Long-Conor/BJT-Amplifier-Design/Single_stage_amplifier/FINAL ASSIGNMENT_PAIR 7.pdf

1 | P a g e

2021C

## RMIT University Vietnam

## School of Science and Technology (SST)

## EEET2600 – Electronics

# BJT AMPLIFIER DESIGN

## Lecturer: Mr. Thanh Pham

## Team Members:

## Student 1 (Nguyen Huynh Hai Long) (S3877624)

## Student 2 (Hoang Thai Kiet) (S3855250)

## Date: 15/01/2022

## Table of Contents

## CIRCUIT 1 – ANALYZING SINGLE-STAGE AMPLIFIER

In this following task, we will be analyzing as well as designing a suitable circuit from the provided

BJT Amplifier schematic through the usage of Multisim Simulation and Elvis Build. From the

given circuit of the single-stage amplifier, we would first analyze the DC bias of the circuit and

determine the Q-point values.

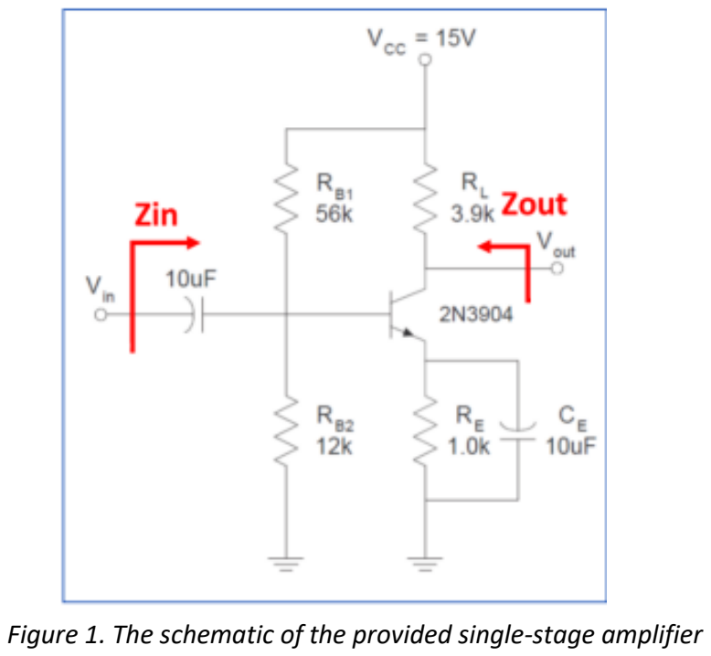
[picture p1: figure]

### 1.1.DC Analysis (1.5 pages max)

We determine the values of the Q-point (ICEQ and VCEQ) by applying the equations:

Figure 1. The schematic of the provided single-stage amplifier

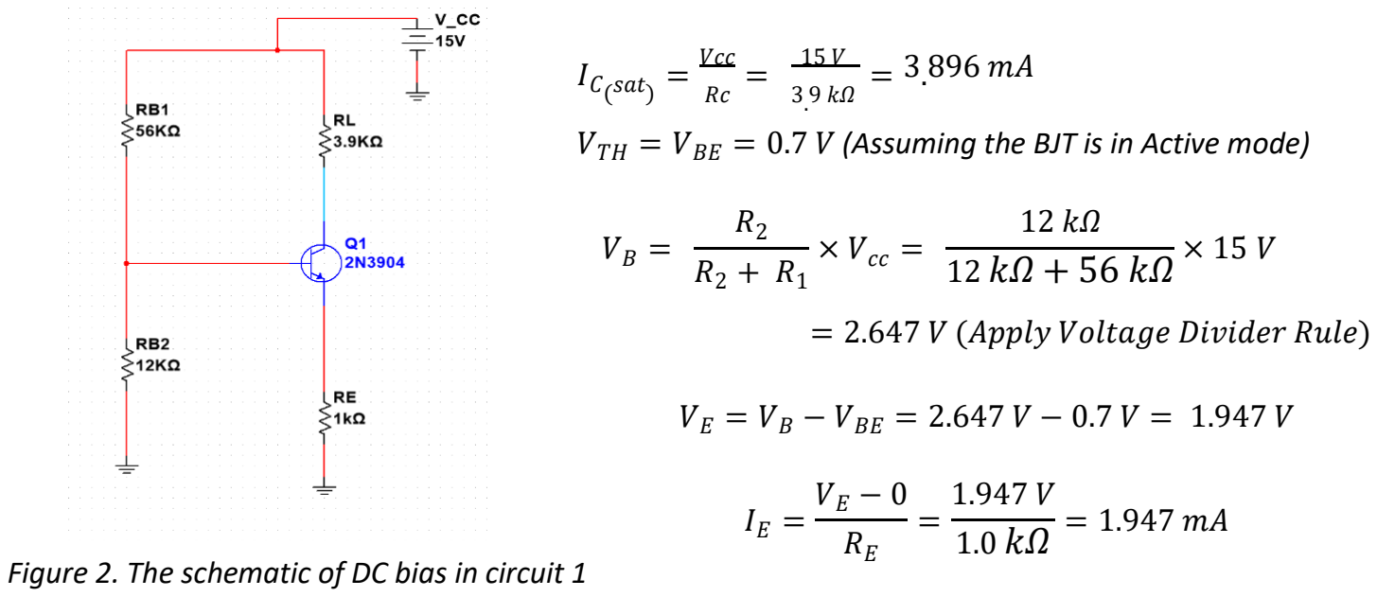
[picture p2: figure]

| Vcc 15 V = 3.896 mA IC( = = sat) Rc 3. 9 kΩ VTH = VBE = 0.7 V (Assuming the BJT is in Active mode) R2 12 kΩ VB = × Vcc = 12 kΩ + 56 kΩ × 15 V R2 + R1 = 2.647 V (Apply Voltage Divider Rule) VE = VB − VBE = 2.647 V − 0.7 V = 1.947 V VE − 0 1.947 V IE = = 1.0 kΩ = 1.947 mA

Figure 2. The schematic of DC bias in circuit 1

IE = IB + IC =

1
β

IC + IC ⇒ IC = (

β
β + 1

) × IE =

100
100 + 1

× 1.947 mA = 1.928 mA

### VCE = VCC − ICRC − IERE = 15 V − (1.928 mA × 3.9 kΩ) − (1.947 mA × 1.0 kΩ) = 5.534 V

⇒ Q(ICQ,VCEQ) = (1.928 mA, 5.534 V).

Draw the Q point together with the DC load line. From there determine the maximum output swing

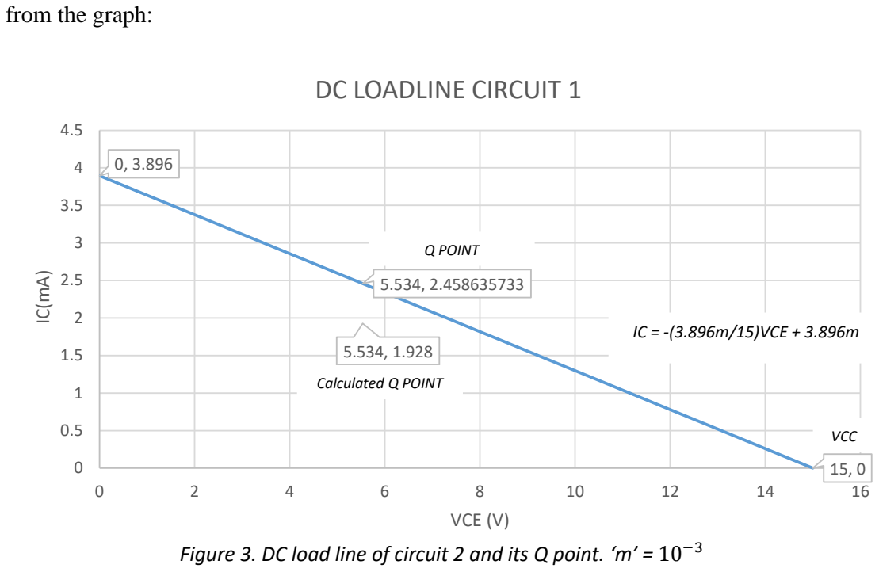
[picture p3: figure]
from the graph:; IC = -(3.896m/15)VCE + 3.896m; VCE (V); DC LOADLINE CIRCUIT 1; Calculated Q POINT; Q POINT; VCC

By looking at the DC load line graph, we observe that the actual Q point in circuit 1 is Q

(2.458635733mA, 5.534V by substituting VCE = 5.534V to the equation IC, which is evaluated

from the coordinates of IC saturation and VCC. To guarantee its maximum output swing, VCE is

foreseen to oscillate in a range: 0 < VCE ≤ 2 ∗ VCEQ = 5.534 ∗ 2 = 11.068, if the VCE

maximum output swing is larger than 11.068, the left wing will be clipped as it exceeds the cutoff

point. Similarly, if the maximum output swing is larger than VCC=9V, VCE will experience both

its sides clipped. As a result, the maximum output swing is 11.068.

### 1.2.AC Analysis (2 pages max)

With values of the Q-point from the DC Analysis, we continued by calculating the h-parameters

for small-signal models:

Figure 3. DC load line of circuit 2 and its Q point. ‘m’ = 10⁻³

gm =

IC
VT

=

1.928 mA
25 mV = 0.07712

Input resistance rπ =

β0
IC

× VT =

100
1.928 mA

× 25 mV = 1296.680 Ω = 1.297 kΩ

Output resistance r0 =

VA + VCE
IC

=

75 V + 5.534 V
1.928 mA = 41.770 kΩ

Then draw the small-signal circuit below:

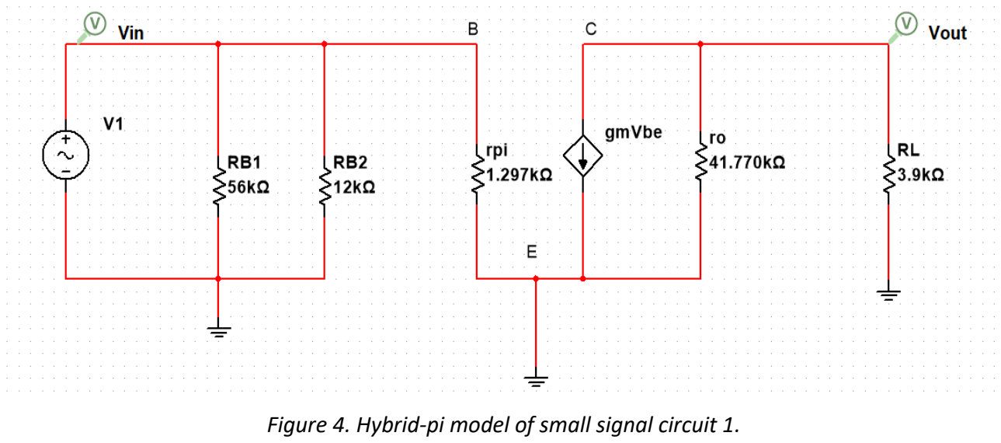
[picture p4: figure]

Utilizing the circuit above from figure., we applied the values from previous DC Analysis and h-

parameters into the formulas of:

- Gain

Av =

V0

VBE

=

V0

Vin

= −gm (

RL × R0
RL + R0

) = −0.07712 × (

3.9 kΩ × 41.770 kΩ
3.9 kΩ + 41.770 kΩ) = −275.084
- Zin

RB =

RB1 × RB2

RB1 + RB2

=

(56 kΩ × 12 kΩ)
(56 kΩ + 12 kΩ)

= 9882.353 Ω = 9.882 kΩ

Zin =

RB × Rπ
RB + Rπ

=

(9.882 kΩ × 1.297 kΩ)
(9.882 kΩ + 1.297 kΩ)

= 1146.520 Ω

- Zout

Figure 4. Hybrid-pi model of small signal circuit 1.

) = (

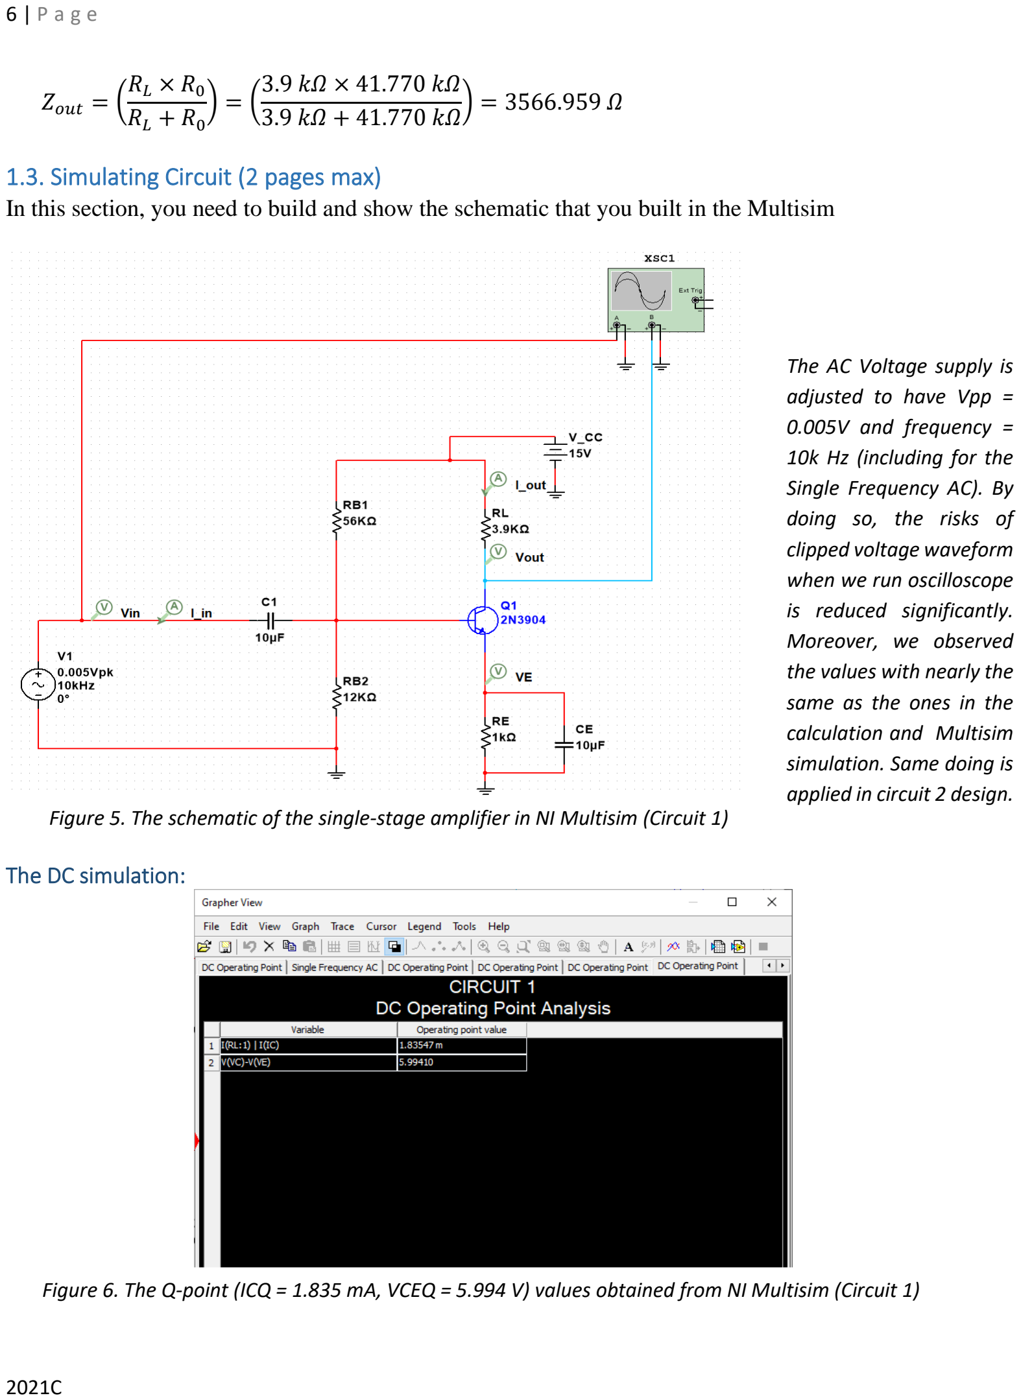
[picture p5: page 6]

Zout = (

RL × R0
RL + R0

3.9 kΩ × 41.770 kΩ
3.9 kΩ + 41.770 kΩ) = 3566.959 Ω

### 1.3. Simulating Circuit (2 pages max)

In this section, you need to build and show the schematic that you built in the Multisim

The DC simulation:

Figure 5. The schematic of the single-stage amplifier in NI Multisim (Circuit 1)

The AC Voltage supply is
adjusted to have Vpp =
0.005V and frequency =
10k Hz (including for the
Single Frequency AC). By
doing so, the risks of
clipped voltage waveform
when we run oscilloscope
is reduced significantly.
Moreover, we observed
the values with nearly the same as the ones in the
calculation and Multisim
simulation. Same doing is
applied in circuit 2 design.

Figure 6. The Q-point (ICQ = 1.835 mA, VCEQ = 5.994 V) values obtained from NI Multisim (Circuit 1)

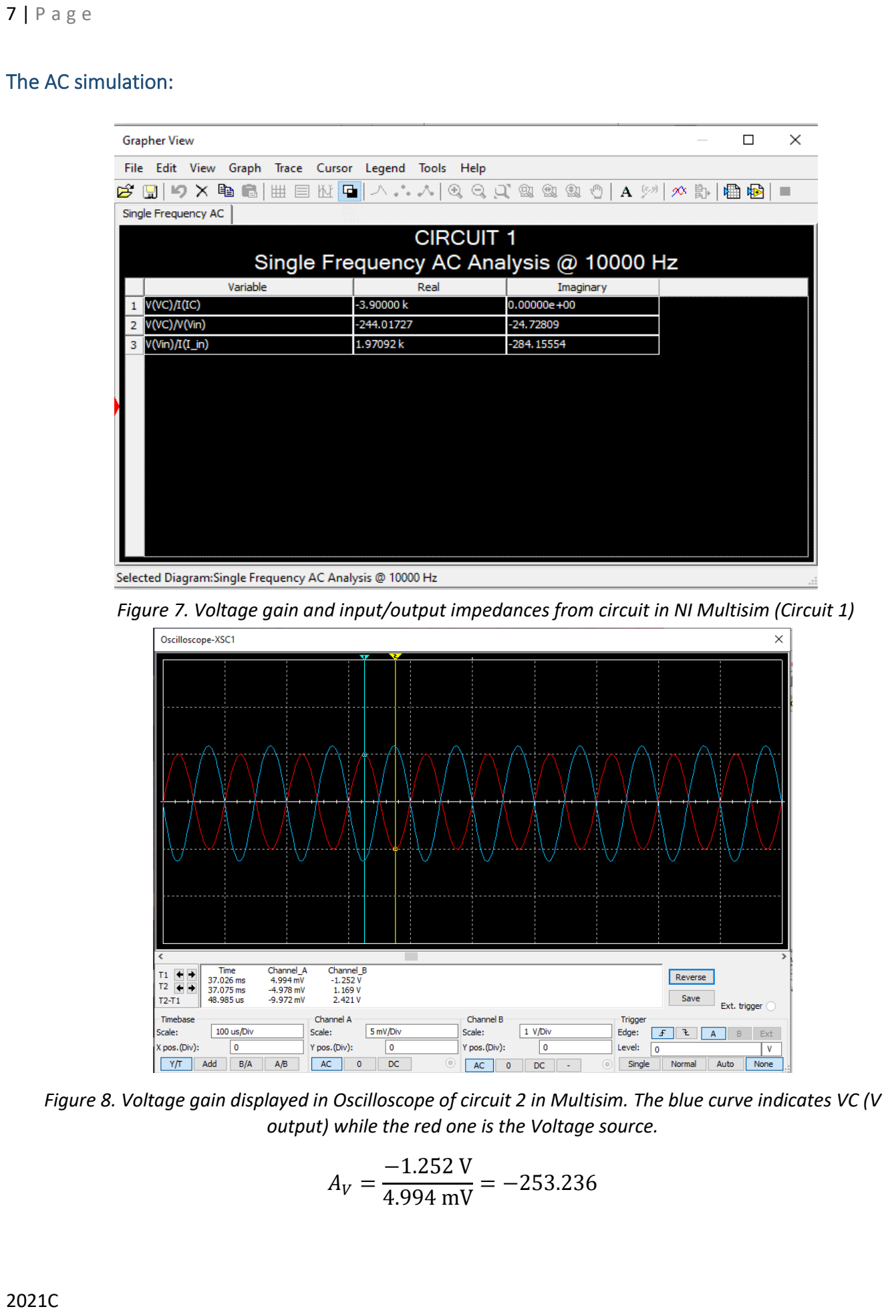
[picture p6: page 7]

The AC simulation:

Figure 7. Voltage gain and input/output impedances from circuit in NI Multisim (Circuit 1)

Figure 8. Voltage gain displayed in Oscilloscope of circuit 2 in Multisim. The blue curve indicates VC (V output) while the red one is the Voltage source.

AV =

−1.252 V
4.994 mV = −253.236

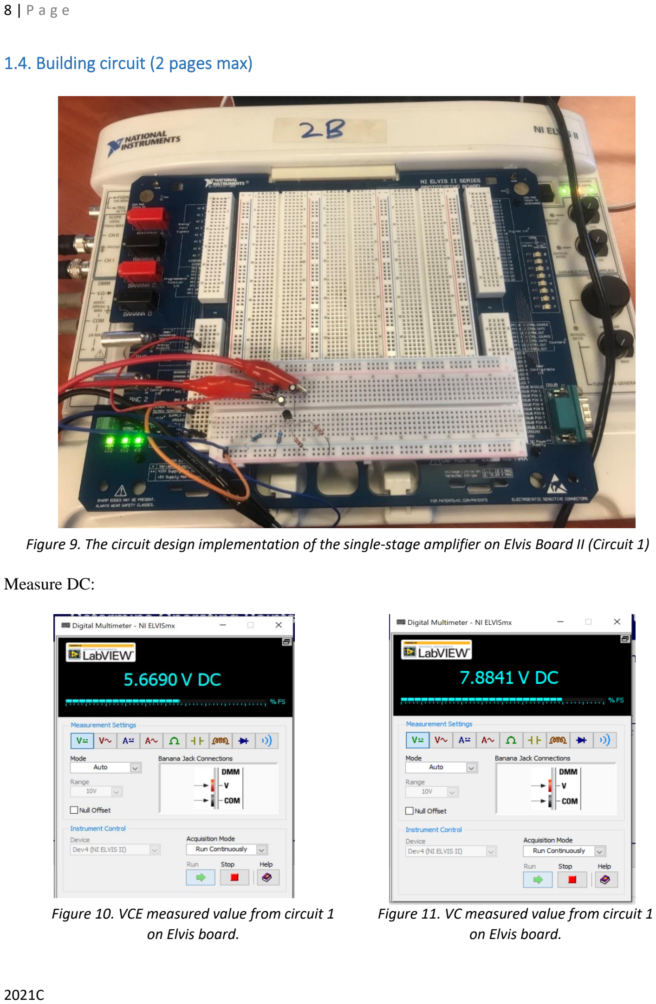
[picture p7: page 8]

### 1.4. Building circuit (2 pages max)

Measure DC:

Figure 9. The circuit design implementation of the single-stage amplifier on Elvis Board II (Circuit 1)

Figure 10. VCE measured value from circuit 1 on Elvis board.

Figure 11. VC measured value from circuit 1 on Elvis board.

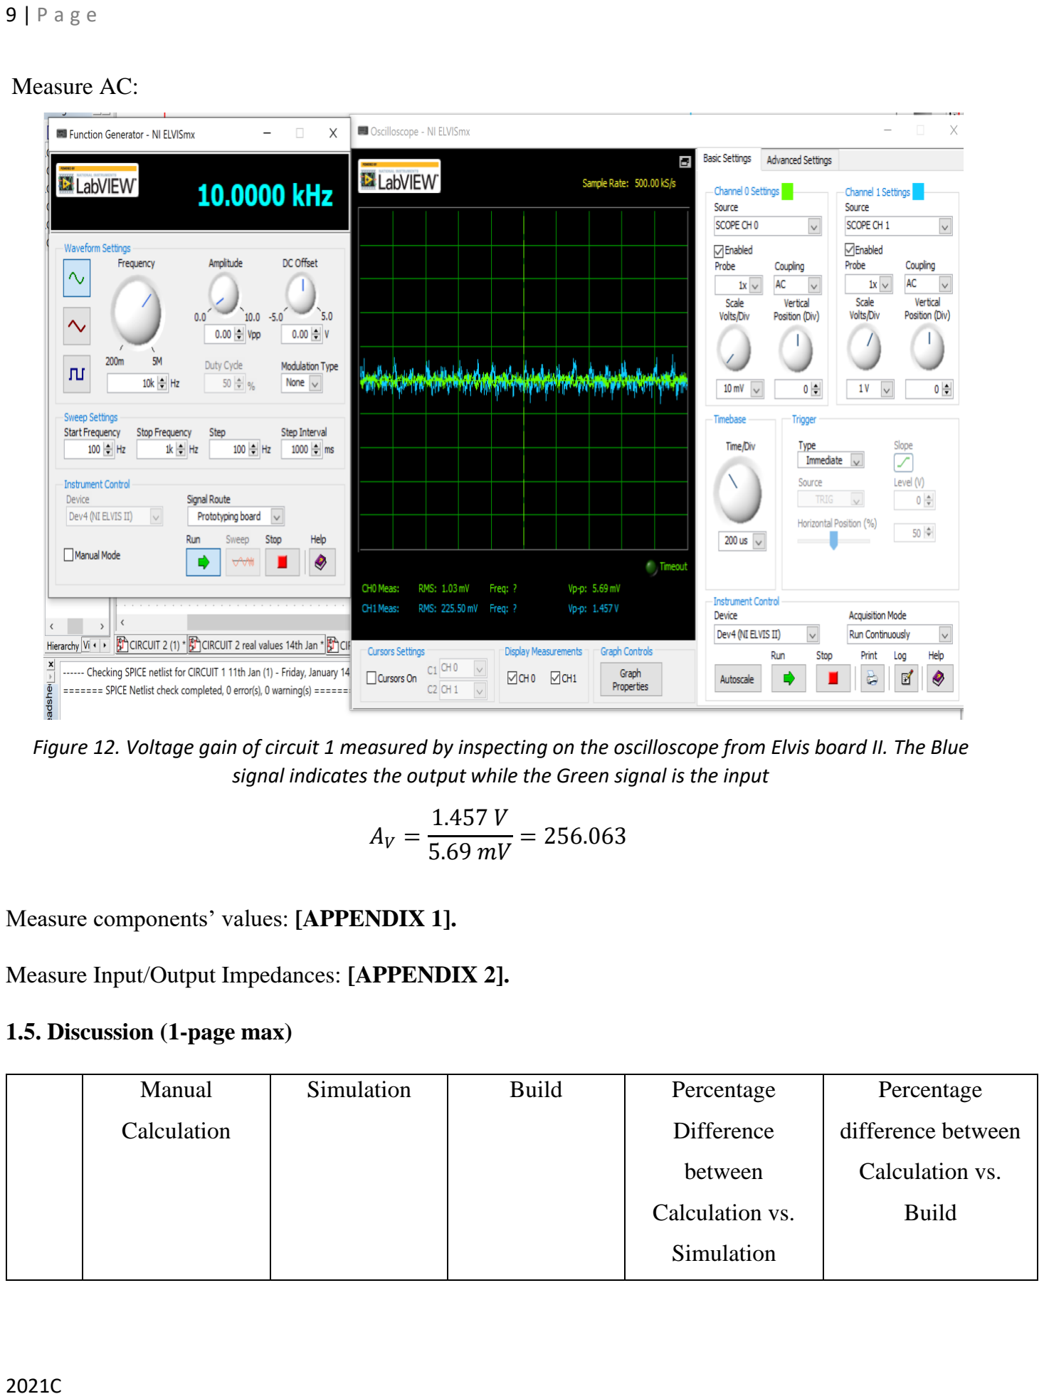
[picture p8: page 9]

Measure AC:

Measure components’ values: [APPENDIX 1].

Measure Input/Output Impedances: [APPENDIX 2].

### 1.5. Discussion (1-page max)

Manual

Calculation

Simulation | Build | Percentage
| | Difference
| | between
| | Calculation vs.
| | Simulation

Percentage

difference between

Calculation vs.

Build

Figure 12. Voltage gain of circuit 1 measured by inspecting on the oscilloscope from Elvis board II. The Blue signal indicates the output while the Green signal is the input

AV =

1.457 V
5.69 mV = 256.063

DC – Q-point | (ICQ): 1.928mA (VCEQ): 5.334V Max output swing(MOS): 11.068V | (ICQ): 1.835mA (VCEQ): 5.994V (MOS): 5.994*2=11.988 | (ICQ): 2.032mA (VCEQ): 5.669V (MOS): 5.669*2=11.338 | (ICQ): 4.824 % (VCEQ): 12.373% (MOS): 8.312% | (ICQ): 5.394 % (VCEQ): 6.280% (MOS): 2.891%
AC – Av | -275.084 | -244.017 | 256.063 | 11.294 % | 6.915 %
AC – Zin | 1146.520 Ω | 1970.920 Ω | 1093.629 Ω | 71.905 % | 4.613 %
AC – Zout | 3566.959 Ω | -3900 Ω | 3534.881 Ω | 9.337 % | 0.899 %

Table 1. Result table of Calculation Vs Simulation Vs Build, along with the percentage difference

between each value (Circuit 1)

% Difference = |1 −

Simulated Multisim Value or Elvis Board Value
Manual Calculated Value | | × 100%

Overall, the analysis and the implementation of building the given first-stage amplifier went

indisputably as the circuit design includes all of the required components needed in the schematic

and were able to obtain results from both Multisim Simulation and Elvis Build.

However, it is worth pointing out that despite the differences among the majority of values between

calculation, simulation and built model; can be seen as having only slightly more when compared

with each other (as shown in [Table 1]), there is one particular difference between the calculation’s

vs simulation at AC – Zin that has a very high percentage difference when compared with the rest.

While the percentage difference between the calculation vs builds for AC – Zin is only at 4.613%,

the percentage difference between the calculation vs simulation for AC – Zin is at its highest of

71.905% (as shown in [Table 1]).

There is no clear explanation for such a significant percentage indifference for the values of AC-

Zin, but one theory might have suggested that it is due to the method of obtaining the Q-point

values between the manual calculation and simulation are not similar. This is further supported by

the difference in Q-point values and max output swing (MOS) between the two methods where

the Q-point and MOS values of manual calculation are Q (1.928 mA, 5.334 V), MOS=11.068V whereas the Q-point values of simulation are Q (1.835 mA, 5.994 V), MOS=11.988V (this greatly

affect the results of the input resistance in the h-parameter and later altered the values of Zin). Aside

from that, the rest of the values from the calculation, simulation and build witness a considerable

difference which is likely due to the connection hole on the breadboard along with the Elvis board

might be too loose (causing the measurement equipment to be less accurate) and the resistor values

are not identical when measured on the board. Further adjustment of wiring connection, choosing

new resistor, and swapping out new breadboard would increase the accuracy and reliability for

testing and designing.

## CIRCUIT 2 – DESIGN SINGLE-STAGE AMPLIFIER (12 PAGES MAXIMUM)

For this particular task, we will be developing a circuit for the single-stage Common Emitter

amplifier and analyzing the circuit according to the required specifications. To build a suitable

circuit that would meet the requirement, we must choose the values for all the resistors along with

all the capacitors present in the schematic. Additionally, the design must utilize the power supply

VCC = 9V; has both AC coupled input and output; a minimum gain at 1KHz of AV = -10 and the

amplifier works for maximum symmetrical output swing. Moreover, the BJT model we used for

circuit 2 design is 2N2222A because it is already available for in our system.

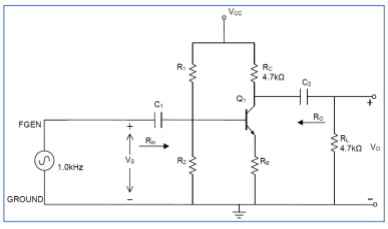
[picture p9: figure]

Figure 13. The schematic of the single-stage Common Emitter amplifier (Circuit 2)

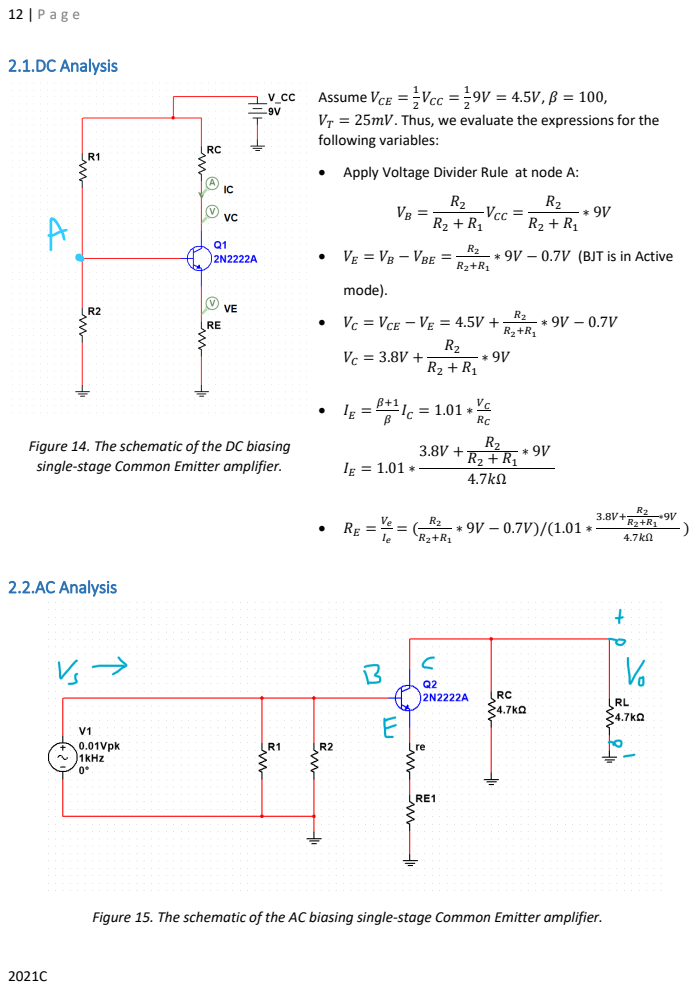
[picture p10: page 12]
2.1.DC Analysis; 2.2.AC Analysis; VCC =; mode).

Assume VCE =
VT = 25mV. Thus, we evaluate the expressions for the
following variables:

• Apply Voltage Divider Rule at node A:

∗ 9V − 0.7V (BJT is in Active

• VE = VB − VBE =

• VC = VCE − VE = 4.5V +

Figure 14. The schematic of the DC biasing
single-stage Common Emitter amplifier.

Figure 15. The schematic of the AC biasing single-stage Common Emitter amplifier.

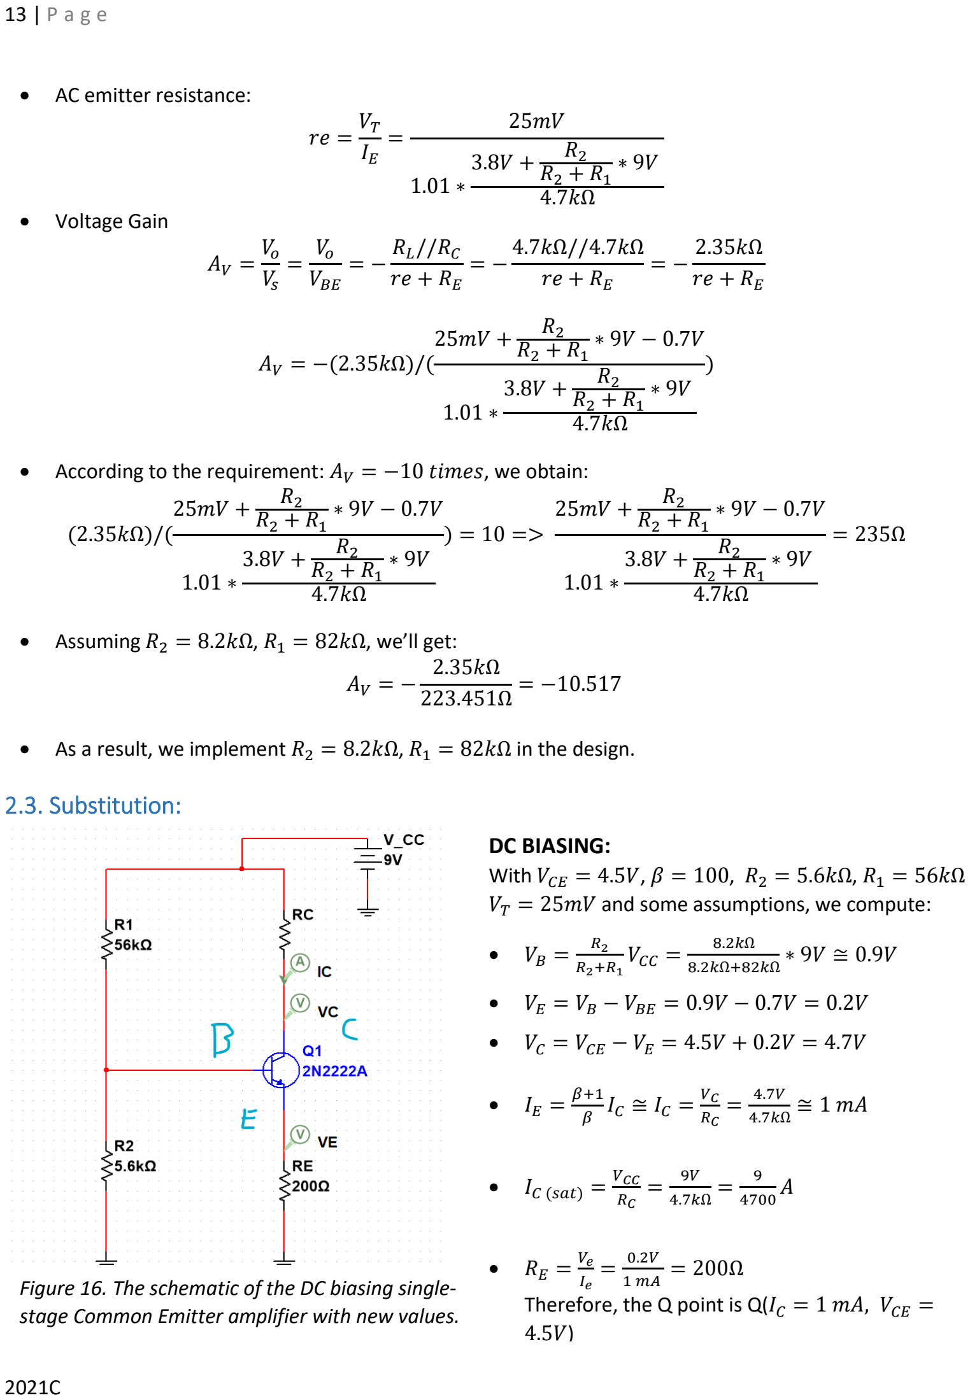
[picture p11: page 13]

### 2.3. Substitution:

- AC emitter resistance:

re =

VT
IE

=

25mV

1.01 ∗

3.8V +

R2
R2 + R1

∗ 9V
4.7kΩ
- Voltage Gain

AV =

Vo
Vs

=

Vo

VBE

= −

RL//RC
re + RE

= −

4.7kΩ//4.7kΩ
re + RE

= −

2.35kΩ
re + RE

AV = −(2.35kΩ)/(

25mV +

R2
R2 + R1

∗ 9V − 0.7V

1.01 ∗

3.8V +

R2
R2 + R1

∗ 9V
4.7kΩ

)

- According to the requirement: AV = −10 times, we obtain:

(2.35kΩ)/(

25mV +

R2
R2 + R1

∗ 9V − 0.7V

1.01 ∗

3.8V +

R2
R2 + R1

∗ 9V
4.7kΩ

) = 10 =>

25mV +

R2
R2 + R1

∗ 9V − 0.7V

1.01 ∗

3.8V +

R2
R2 + R1

∗ 9V
4.7kΩ

= 235Ω

- Assuming R2 = 8.2kΩ, R1 = 82kΩ, we’ll get:

AV = −

2.35kΩ
223.451Ω = −10.517
- As a result, we implement R2 = 8.2kΩ, R1 = 82kΩ in the design.

DC BIASING:
With VCE = 4.5V, β = 100, R2 = 5.6kΩ, R1 = 56kΩ VT = 25mV and some assumptions, we compute:
- VB =

R2
R2+R1

VCC =

8.2kΩ
8.2kΩ+82kΩ

∗ 9V ≅ 0.9V

- VE = VB − VBE = 0.9V − 0.7V = 0.2V
- VC = VCE − VE = 4.5V + 0.2V = 4.7V
- IE =

β+1
β

IC ≅ IC =

VC
RC

=

4.7V
4.7kΩ

≅ 1 mA

- IC (sat) =

VCC
RC

=

9V
4.7kΩ

=

9
4700

A

- RE =

Ve
Ie

=

0.2V
1 mA

= 200Ω
Therefore, the Q point is Q(IC = 1 mA, VCE = 4.5V)

Figure 16. The schematic of the DC biasing single-stage Common Emitter amplifier with new values.

AC BIASING

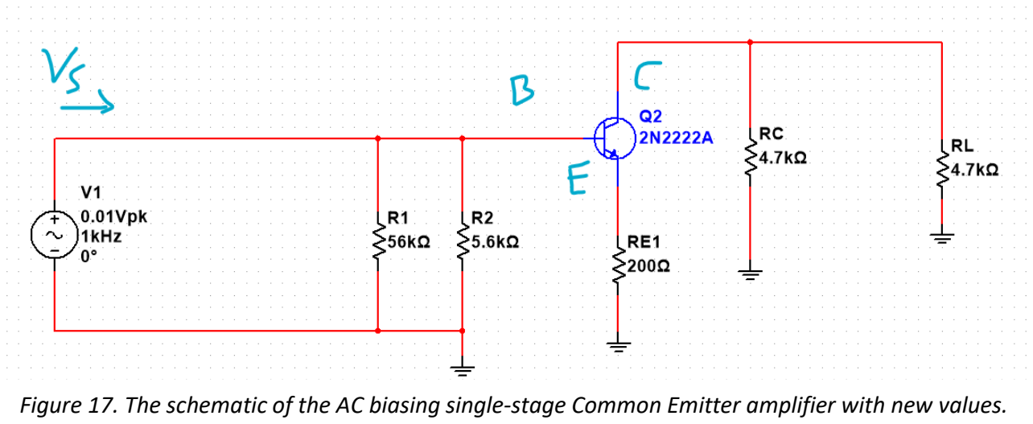
[picture p12: figure]
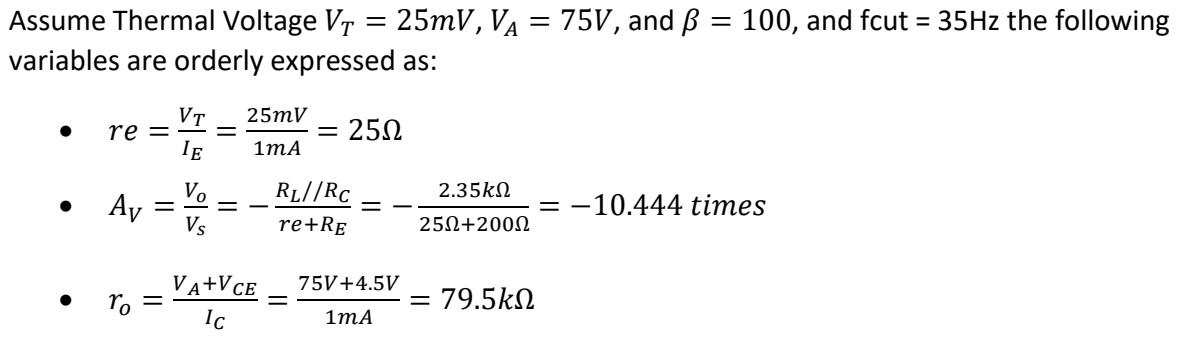
[picture p13: figure]
variables are orderly expressed as:; = −10.444 times; VA+VCE

Assume Thermal Voltage VT = 25mV, VA = 75V, and β = 100, and fcut = 35Hz the following

Figure 17. The schematic of the AC biasing single-stage Common Emitter amplifier with new values.

- Zin = (R1//R2)//β(re + RE) = (8.2kΩ//82kΩ)//150(25Ω + 200Ω)

Zin = 7.454kΩ//22.5kΩ = 5. 599kΩ

- Zout = (RC)//ro = (RL) (rois too big so we can neglect it)
Zout = 4. 7kΩ

With f=35Hz, we can adjust the values for the Capacitors by doing as followed:

- The XC1 of the coupling capacitor, C1, should be at least 10 times less than Zin

C1 =

1
2π ∗ (f = 35Hz) ∗ XC1

=

1
2π ∗ 35Hz ∗ 0.1 ∗ Zin

= 9. 465µF

- The XC2 of the coupling capacitor, C2, should be at least 10 times less than Zin

C1 =

1
2π ∗ (f = 35Hz) ∗ XC2

=

1
2π ∗ 35Hz ∗ 0.1 ∗ Zout

= 9. 675µF

So, we will pick C1 = C2 = 10µF for the design implementation on Elvis board.

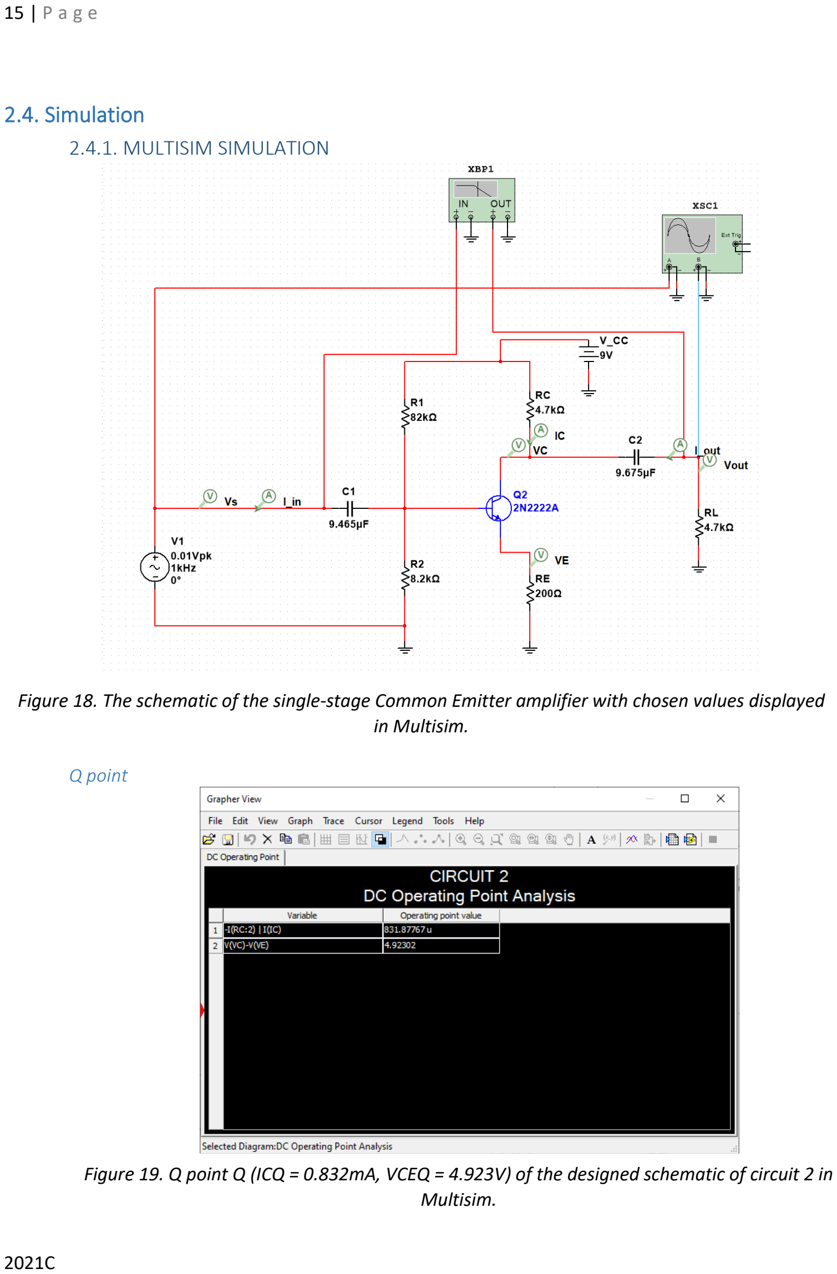
[picture p14: page 15]

### 2.4. Simulation

2.4.1. MULTISIM SIMULATION

Q point

Figure 18. The schematic of the single-stage Common Emitter amplifier with chosen values displayed in Multisim.

Figure 19. Q point Q (ICQ = 0.832mA, VCEQ = 4.923V) of the designed schematic of circuit 2 in Multisim.

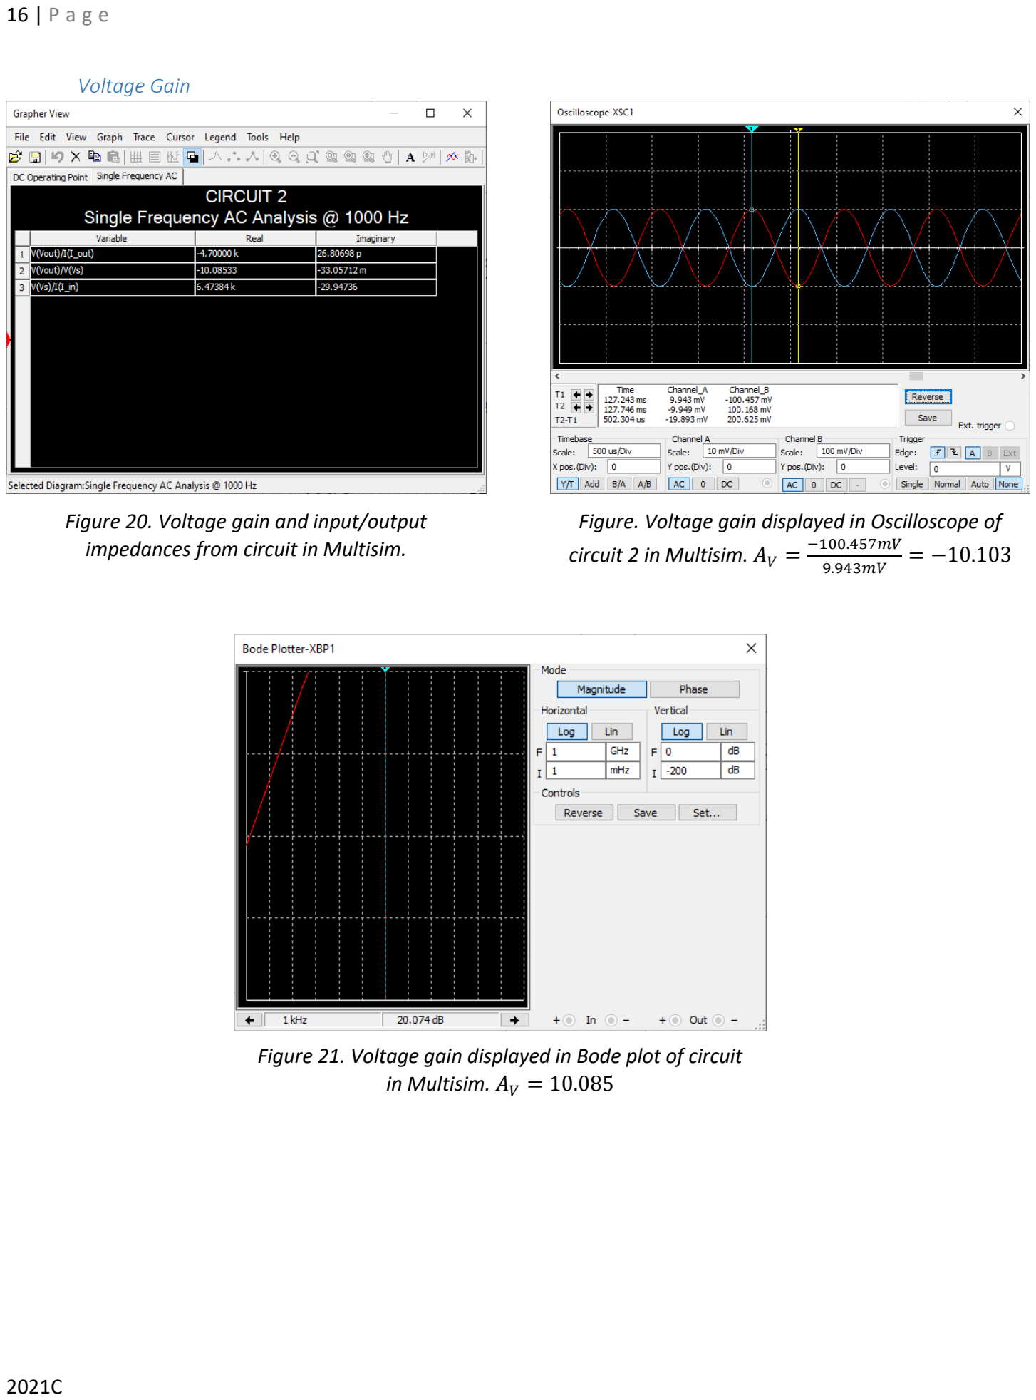
[picture p15: page 16]

Voltage Gain

Figure 20. Voltage gain and input/output impedances from circuit in Multisim.

Figure. Voltage gain displayed in Oscilloscope of circuit 2 in Multisim. AV =

−100.457mV
9.943mV

= −10.103

Figure 21. Voltage gain displayed in Bode plot of circuit in Multisim. AV = 10.085

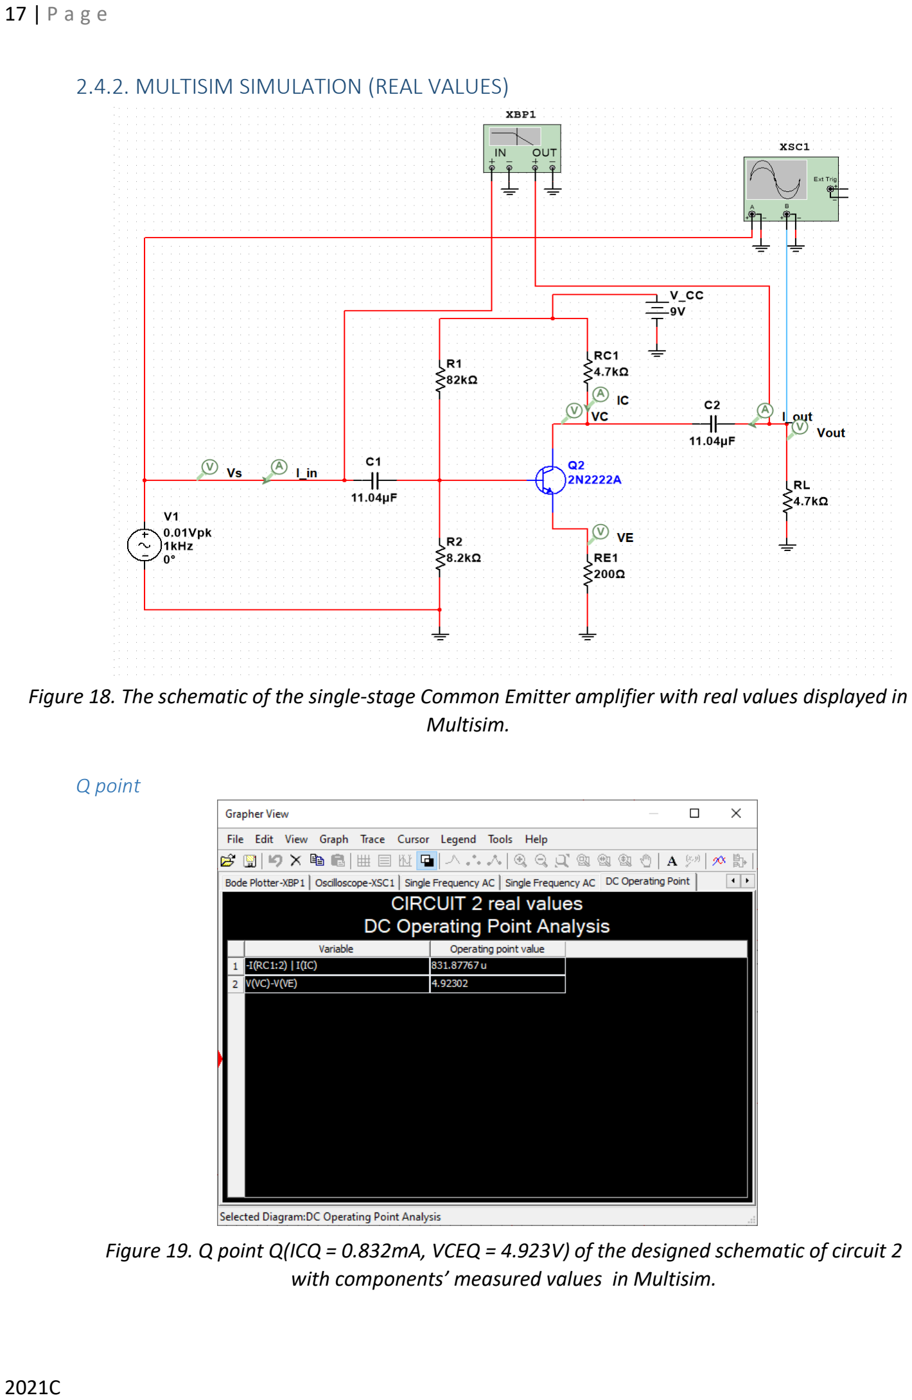
[picture p16: page 17]

2.4.2. MULTISIM SIMULATION (REAL VALUES)

Q point

Figure 18. The schematic of the single-stage Common Emitter amplifier with real values displayed in Multisim.

Figure 19. Q point Q(ICQ = 0.832mA, VCEQ = 4.923V) of the designed schematic of circuit 2 with components’ measured values in Multisim.

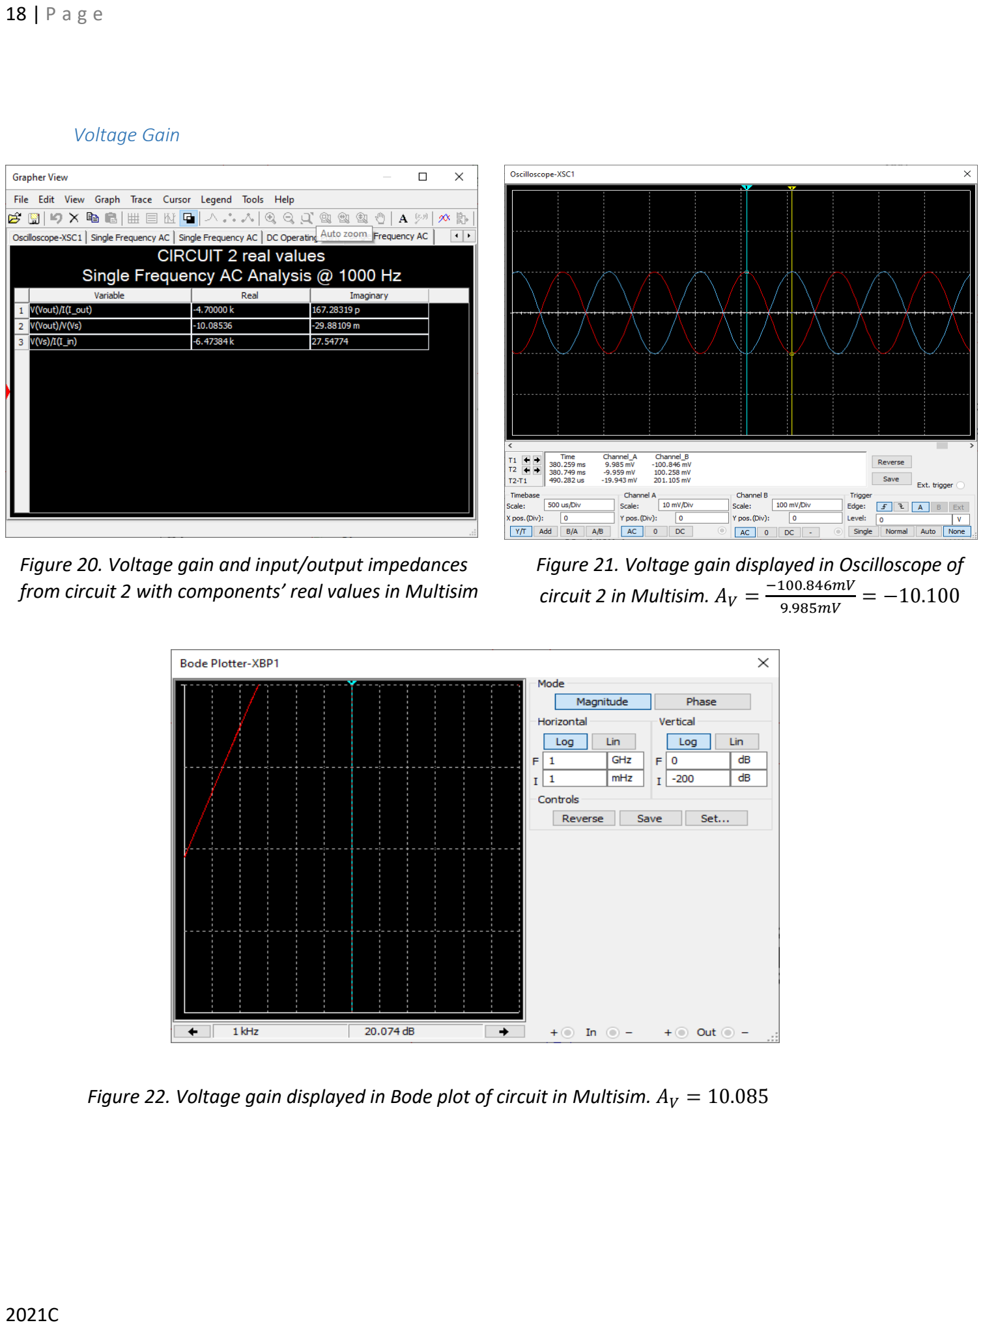
[picture p17: page 18]

Voltage Gain

Figure 22. Voltage gain displayed in Bode plot of circuit in Multisim. AV = 10.085

Figure 20. Voltage gain and input/output impedances from circuit 2 with components’ real values in Multisim

Figure 21. Voltage gain displayed in Oscilloscope of circuit 2 in Multisim. AV =

−100.846mV
9.985mV

= −10.100

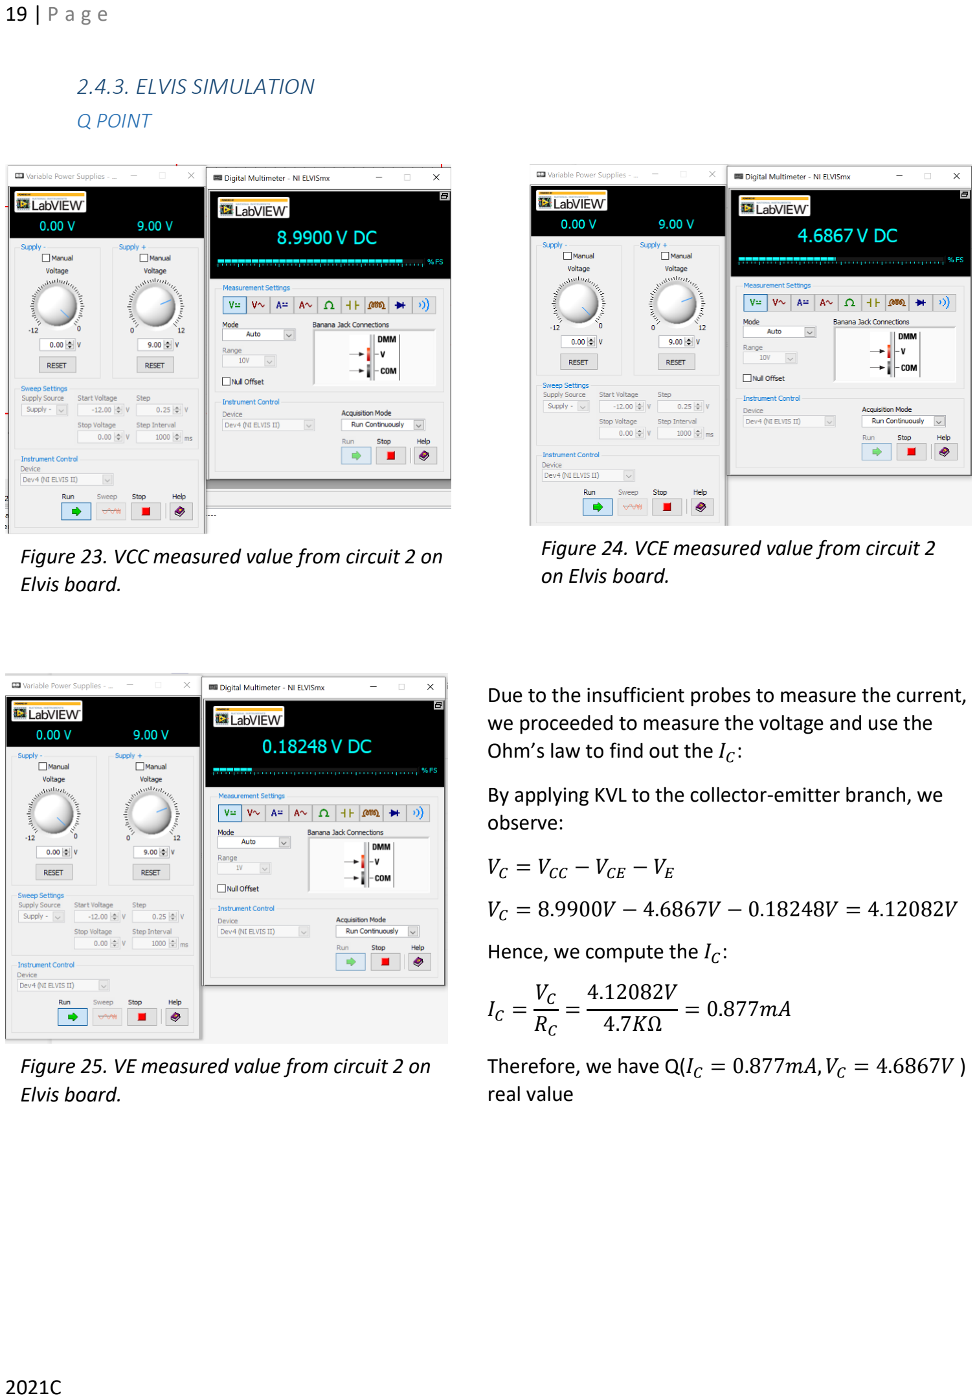
[picture p18: page 19]

2.4.3. ELVIS SIMULATION
Q POINT

Figure 23. VCC measured value from circuit 2 on Elvis board.

Figure 24. VCE measured value from circuit 2 on Elvis board.

Figure 25. VE measured value from circuit 2 on Elvis board.

Due to the insufficient probes to measure the current, we proceeded to measure the voltage and use the Ohm’s law to find out the IC:

By applying KVL to the collector-emitter branch, we observe:

VC = VCC − VCE − VE

VC = 8.9900V − 4.6867V − 0.18248V = 4.12082V

Hence, we compute the IC:

IC =

VC
RC

=

4.12082V
4.7KΩ

= 0.877mA

Therefore, we have Q(IC = 0.877mA, VC = 4.6867V ) real value

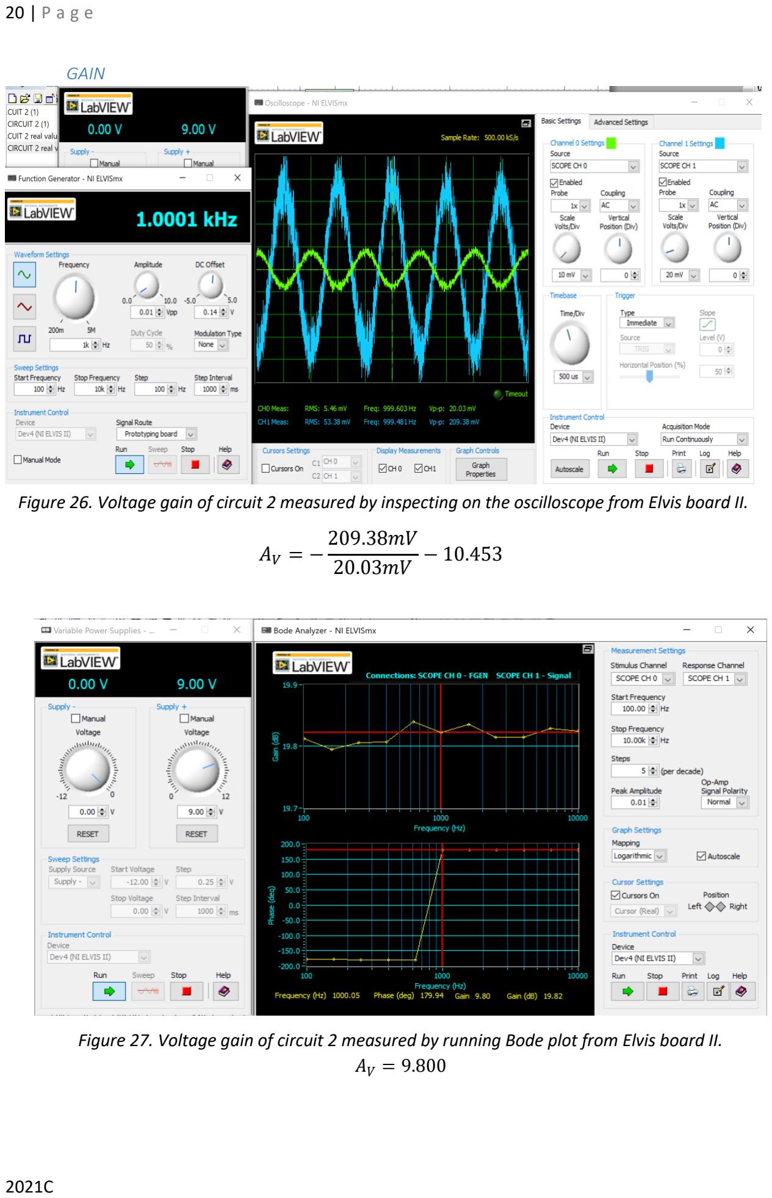
[picture p19: page 20]

GAIN

Figure 26. Voltage gain of circuit 2 measured by inspecting on the oscilloscope from Elvis board II.

AV = −

209.38mV
20.03mV − 10.453

Figure 27. Voltage gain of circuit 2 measured by running Bode plot from Elvis board II. AV = 9.800

### 2.5. Build

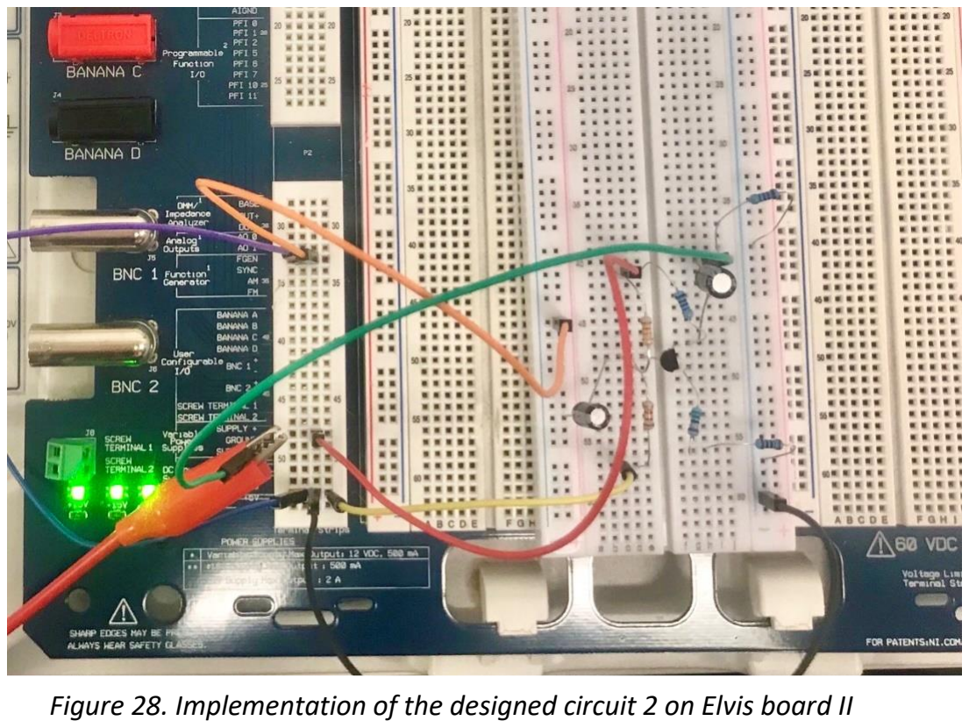
[picture p20: figure]

### 2.6. Discussion

DC LOADLINE (by using Mx word)

Figure 28. Implementation of the designed circuit 2 on Elvis board II

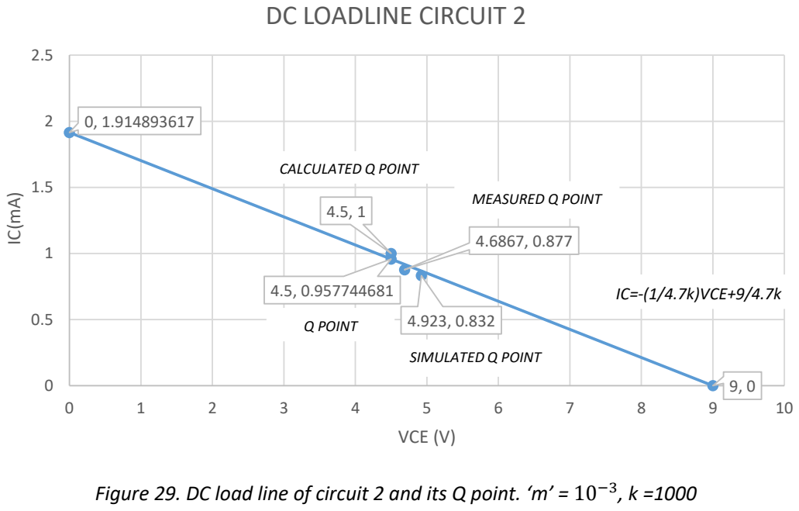
[picture p21: figure]
MEASURED Q POINT 4.6867, 0.877; IC=-(1/4.7k)VCE+9/4.7k; VCE (V); DC LOADLINE CIRCUIT 2; CALCULATED Q POINT; Q POINT; SIMULATED Q POINT

Figure 29. DC load line of circuit 2 and its Q point. ‘m’ = 10⁻³

| Manual Calculation | Simulation (Real values) | Build | Percentage Difference between Calculation vs. Simulation | Percentage difference between Calculation vs. Build
DC – Q-point | (ICQ): 1 mA (VCEQ): 4.5V (MOS): 4.5*2=9V | (ICQ): 0.832mA (VCEQ): 4.923V (MOS): 4.923*2=9.846V | (ICQ): 0.877mA (VCEQ):4.686V (MOS): 4.686*2=9.372V | (ICQ): 16.8% (VCEQ): 8.592% (MOS):9.400% | (ICQ): 12.3% (VCEQ): 4.149% (MOS):4.133%
AC – Av | -10.444 | (Oscilloscope): -10.100 (Bode plot): 10.085 | (Oscilloscope): -10.453 (Bode plot): 9.800 | (Oscilloscope): 3.294% (Bode plot): 3.437% | (Oscilloscope): 0.086% (Bode plot): 6.166%

Table 2. Result table of Calculation Vs Simulation Vs Build, along with the percentage

difference between each value (Circuit 2)

Overall, the development and process of designing the single-stage Common Emitter amplifier

went well as the circuit design included all the required components together with the implements

of the 9V power supply, having both AC coupled input and output as well as satisfying the

requirement of a minimum gain of AV = -10 at 1KHz

It is important to emphasize that the differences in the Voltage Gain and Q-point between

calculation vs simulation vs build are likely from the circumstances of which the simulation and

build is constructed throughout the development. Since the circuit design of simulation is built in

an ideal environment (where the board doesn’t have any issues or problems), the values are exact

and always remain constant without any interference of outside force that could impact the

outcome results. While the circuit design of the build has multiple factors that could affects the

overall design considerably (such as loose connection in the connection hole, the board having its

own resistance, the board producing noise, etc.).

However, the Q point when comes to simulation and implementation witness its sides clipped.

Even though the assumption was made, the percentage of difference is around 10% when

compared to the simulations. This is due to the changes in values from the components of the design in reality. Hence, the requirement where the design produces a maximum symmetrical

output swing is now achieved.

Aside from that, the values from calculation, simulation and build witness a considerable

difference as it can be seen to having slightly more when compared with each other (as shown in

[Table 2]). Further adjustment on the wiring connections, swapping out new breadboard alongside

choosing new resistors values to ensure the accuracy and reliability when testing and re-designing.

## REFERENCES

Thomas L. Floyd, Electronic Devices : Conventional Current Version, Global ed. , Tenth ed. Harlow,

England: Pearson, 2018., page 273-292

## APPENDIX

## APPENDIX 1: THE VALUES OF COMPONENTS

## MEASURED ON ELVIS BOARD II (CIRCUIT 1) NOTED DOWN

IN MULTISIM.

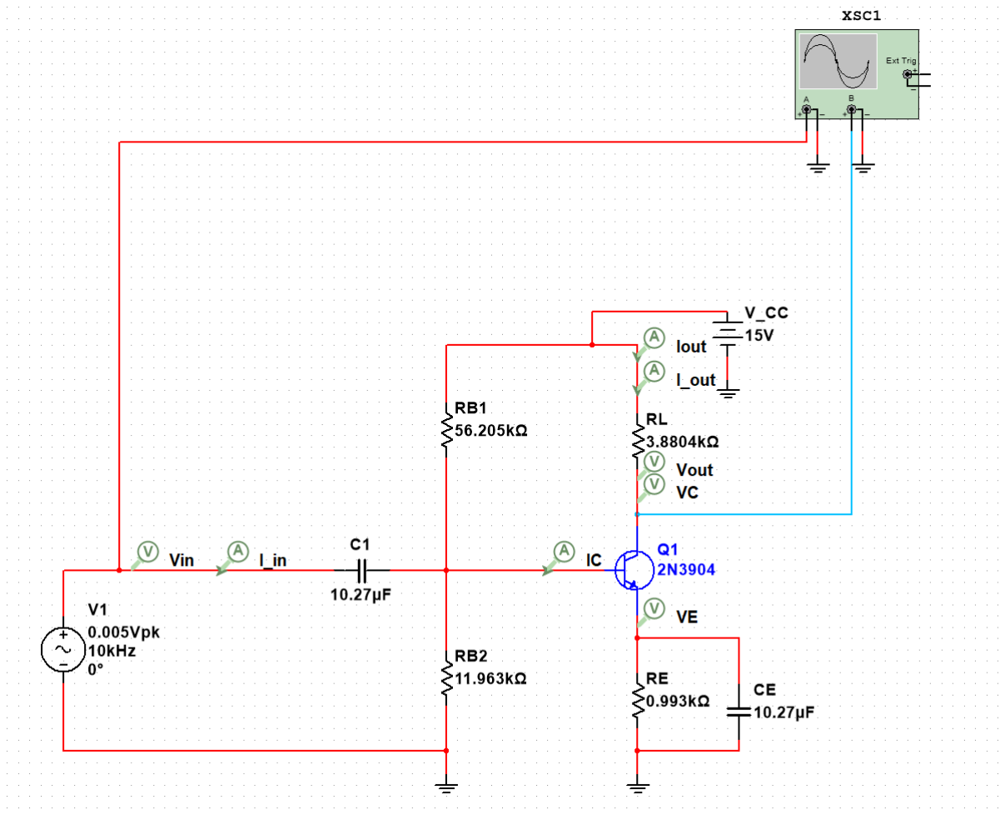
[picture p22: figure]

## APPENDIX 2: THE VALUES OF ZIN AND ZOUT OBTAIN

## FROM THE SUBSTITUTION OF MEASURED AND REAL

## VALUES ON ELVIS BOARD II (CIRCUIT 1)

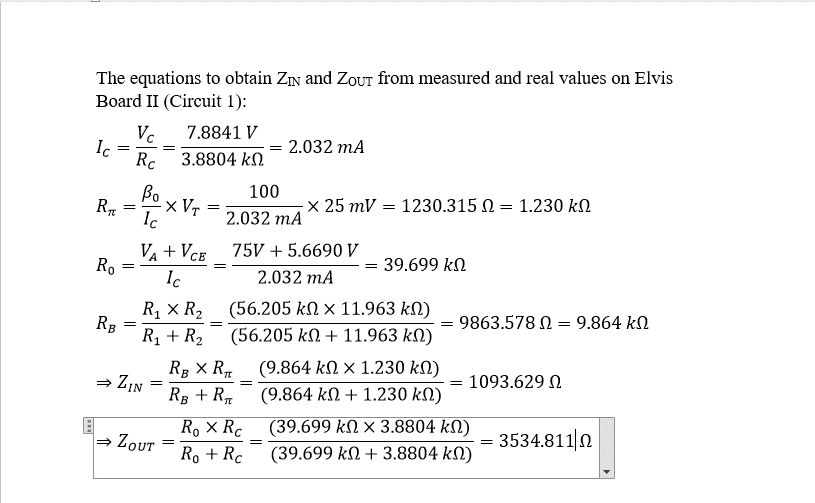
[picture p23: figure]

## APPENDIX 3: CIRCUIT 2 DC LOADLINE DISPLAYED ON WINDOW

10 CALCULATOR'S GRAPHING.

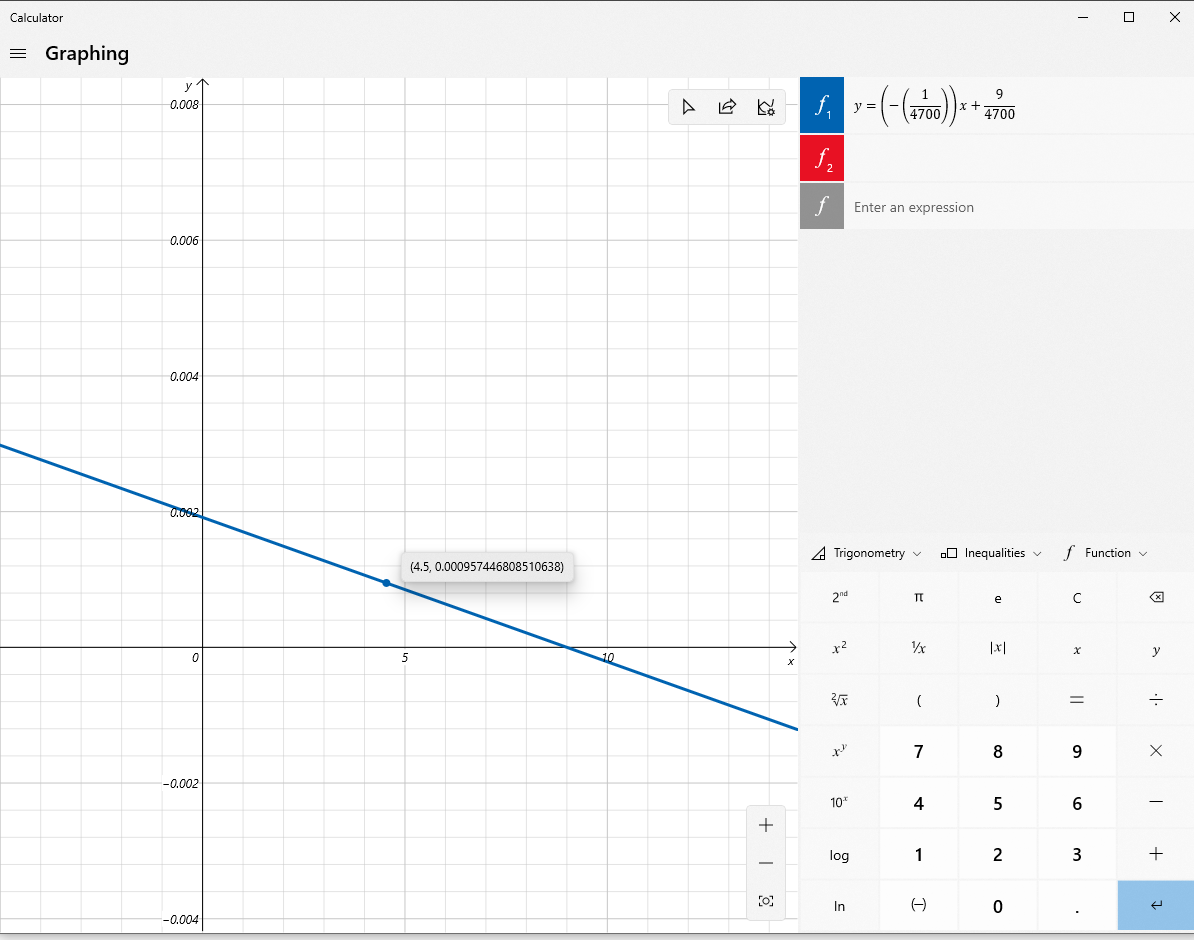
[picture p24: figure]

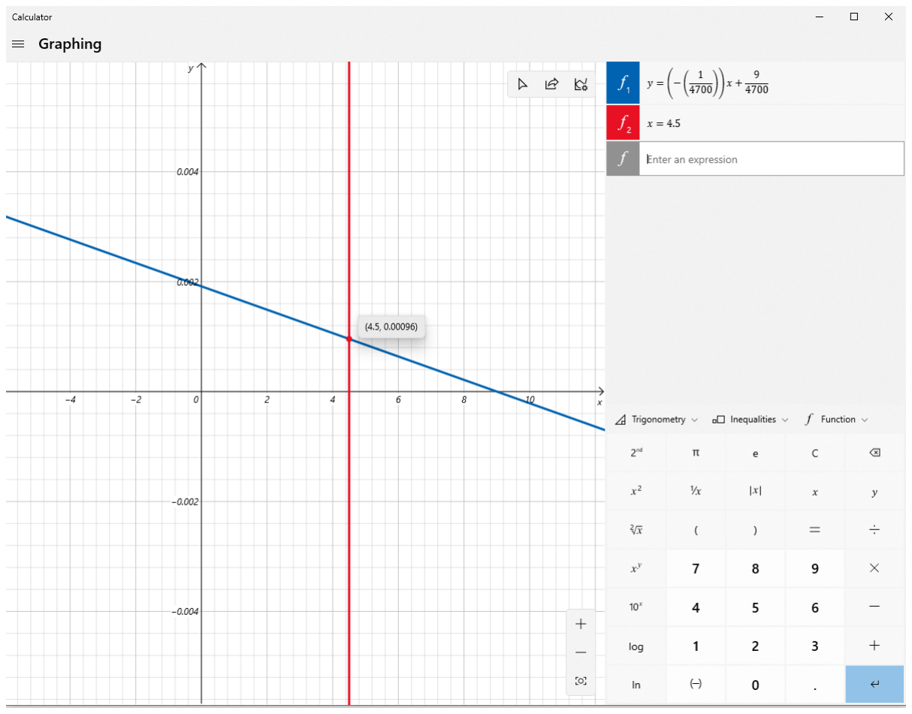
[picture p25: figure]

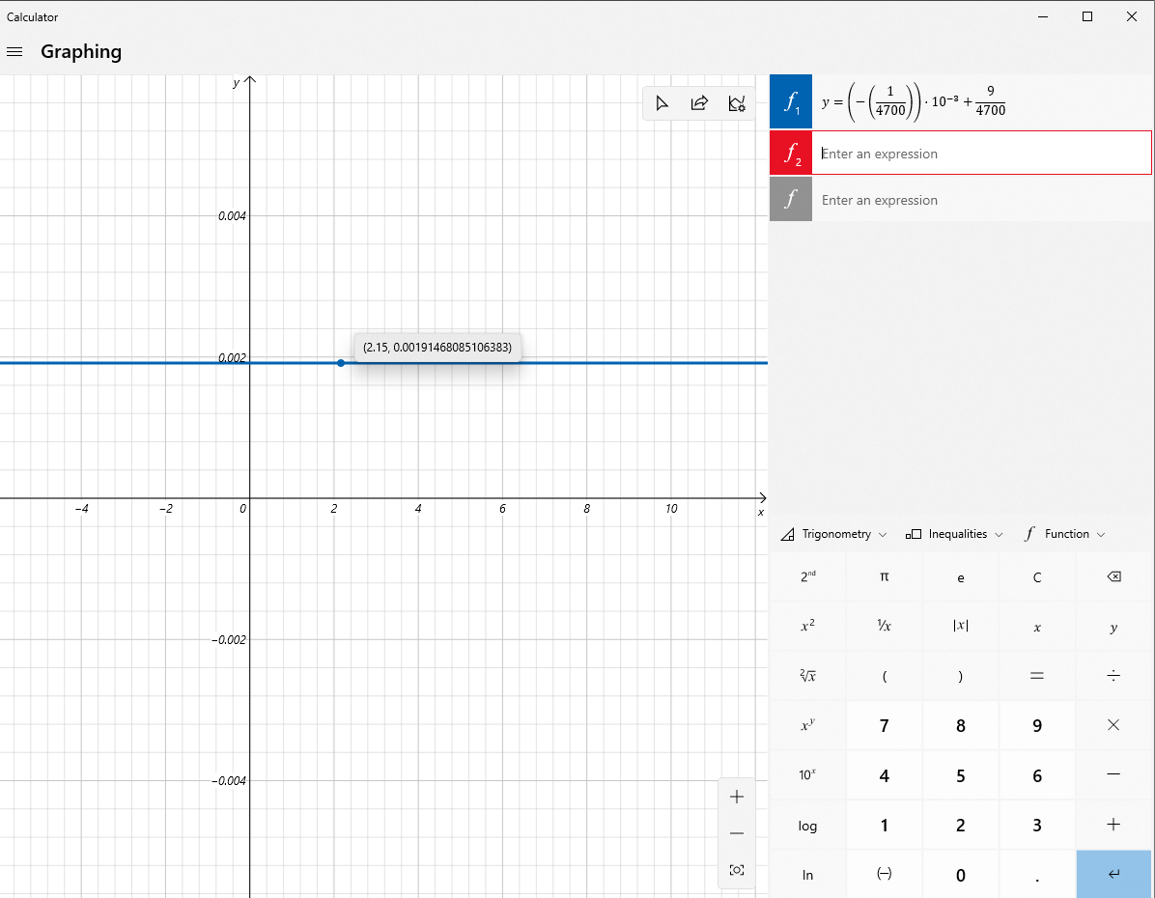
[picture p26: figure]
