Long-Conor/BJT-Amplifier-Design/(list of files, drawings)

Other design files:
Single_stage_amplifier/Circuit_1/CIRCUIT 1 (real values).ms14
Single_stage_amplifier/Circuit_1/CIRCUIT 1 .ms14
Single_stage_amplifier/Circuit_2/CIRCUIT 2 real values.ms14
Single_stage_amplifier/Circuit_2/CIRCUIT 2.ms14
